dennishatton/TI-99-4a_SD_Disk_Project/TI99_DSR_patches/27c128 jumper.jpg

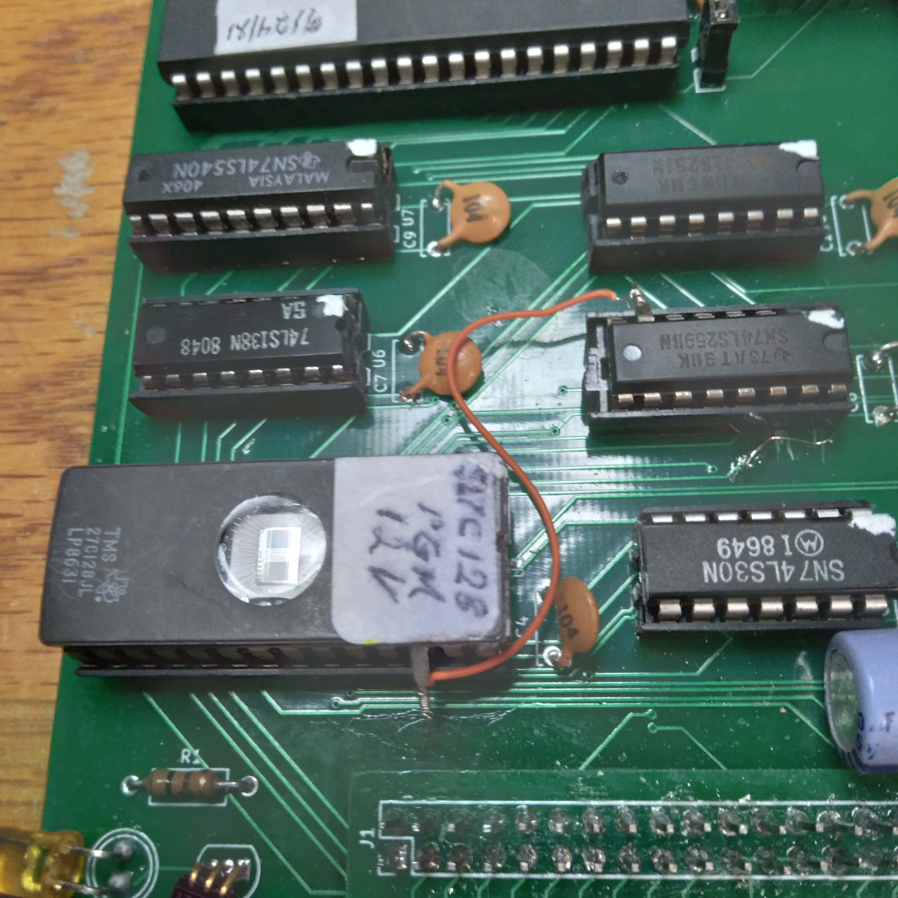
TI99_DSR_patches/27c128 jumper.jpg
