dennishatton/TI-99-4a_SD_Disk_Project/README.md

# TI-99/4a SD Disk Project
Allows TI to use floppy images on SD card

Note:<br />

	7/11/22
	Added DSK.volume#.filename to allow access to all volumes without being mounted.
	Added CALL CATALOG or CALL CAT due to conflict with RBX CALL CAT
	6/30/22
	16k patch.zip: Added CALL MAP To See which volumes are mounted to drives
	SD_Drive_540.zip Updated for CALL MAP
	MAP.zip
	I orignally use a 74ls541 as buffer and have two boards one with 74ls540
	Thinking it would be faster, But makes no difference.
	If you would like a copy of SD_Drive_541.zip Email me.
	6/27/22
	VOLMGR.ZIP highlighted volume number and fixed minor bugs
	6/25/22
	VolMgr.zip Added disk rename and quick format.
	Changed SYSTEM volume to 90k, Allows faster transf
	6/20/22
	TI99_DSR_patches:
	16k Patch.zip Added CALL CAT
	System:
	CALL VOLMGR.zip	Fixed transfer complete message
	Added CALL CAT.zip
	Added README (Subprograms Usage)
	TIVOL255
	
	6/12/22
	Change to load VolMgr from Volume 255, to allow updates to VolMgr
	volmgr.zip: Added auto repeat on keys, Added FCTN-4 Cancel to transfer
	SD_Drive_540.zip: Fixed transfer to only send size of volume instead of always 360k, Added monitor DSR pin for user cancel of transfer, 	Included avrasm2
	SD_Drive.zip: Tied DSR_EN 74LS259 Pin 4 to Atmega PD2 pin 12 to monitor User cancel of transfer.	

	6/6/22 	SD_Drive PCB removed 5v from pin 26 of 27C128 and tied to pin 7 of 74LS259,
	To allow optional 16k rom with CALL VOLMGR in DSR.
	5/27/22 Added Volume Manager EA5 to load into memory

	I have also uploaded 32K board, RS232/PIO board and ESP-01 adaptor for Telnet transfers
	
	I'm not trying to re-invent TI-99/4a or turn it into a PC.
	My goal is to keep it compatible with an original TI system.
	If you have already order the old PCBs as I have.
	You will need the adaptor board. See the Adaptor ReadMe.pdf in KiCad folder.
	The pin header will also be used for the optional 32K daughter board.
	I recommend you use a long pin wire wrap edge card connector for side port, If you want to mount in a case.
		
	This should go without saying but the edge card connector goes on back of the board, Not front components side.
	Also If you can't figure out where the emitter, base & collector is on a transistor. This project is not for you.
	Must power up SD drive first then console.

I built this on a wire wrap board and tested.<br />
I have included the KICAD schematic and PCB.<br />
You must format SD card to EXFAT allocation unit size 512k.<br />
The reason I use 512k clusters is make sure another file can't be save between volumes.<br />
You will need to find a TI DSR rom. I'm not including one.<br />
You can use TI DSR rom as is or apply patches for CALL MOUNT and 360k disk images<br />
I'm using an ATMEGA162 to interface with the TI. Source included for MPLABX<br />
The volumes are V9T9 sector images of TI disk.<br />
You can use Disk Manager 2 on TI or on PC use TI99DIR.<br />
I'm also including some PC utilties.<br />
To use the PC utilities, You will need Visual C++ Redistributable for Visual Studio 2019.<br />
Go here to download for your computer.<br />
https://support.microsoft.com/help/2977003/the-latest-supported-visual-c-downloads<br />
There is a cartridge VolumeMgr.bin to list volumes on the TI.<br />
The cartridge is optional, You will need FLASHROM99 to run it.<br />
<br />
If someone does build this, Please let me know.<br />
I have mine working for a couple years.<br />
<br />
You must use a 16MHz Atmega162<br />
Low High Extend<br />
with fuses FF D9 FF<br />
<br />
Can use ESP-01 adaptor to Telnet send/receive volumes from PC to SD Drive.<br />
Also allowed the TI to access the ATmega usart<br />
by writing to the FDC Command register and reading or writing data registers.<br />
0x83 read usart status, 0x84 read usart data, 0x85 write usart data.<br />
There is a 128 byte buffer storing status & char received. (64 chars)<br />
The baud is 115.2k 8N1.<br />
<br />
volmgr
Volume Manger.



DiskTest
Disk test with TI Disk Manager.

RS232Front
RS232Back
RS232Test
RS232 test with my EPROM programmer.

32KFront
32KBack
32KTest
32K Memory test.

flat
Upright
Attached with Velcro.
Remove the sliding door on the speech synthesizer helps it seat better.

TI_Telnet
TI Sending Volume to PC via Telnet Xmodem

PC_Telnet
PC Receiving Volume from TI via Telnet Xmodem 1.8 KB/Sec
