dennishatton/TI-99-4a_SD_Disk_Project/System/README.txt

Subprograms Usage: 

	CALL MOUNT(drive,volume)
	Mounts drive 1-3, volume 000-255

	CALL CATALOG or CALL CAT
	CALL CAT(drive) or CALL CAT(volume)
	Cataloges a drive 1-3 or volume 000-255

	CALL VOLMGR
	Volume Manager for SD Drive
	
	CALL MAP
	Displays which volumes are mounted to drives 1-3

	    (000-255)
	DSK.VOLUME#.filename
	Allows access to all volumes without being mounted
