dennishatton/TI-99-4a_SD_Disk_Project/KiCad_6/Adaptor Read Me.pdf

You only need the adaptor board if you using the old PCB.

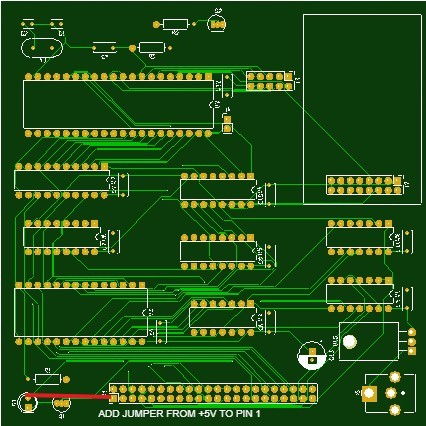
[picture p2: figure]

You need to add 5v jumper on the SD Drive board

Then

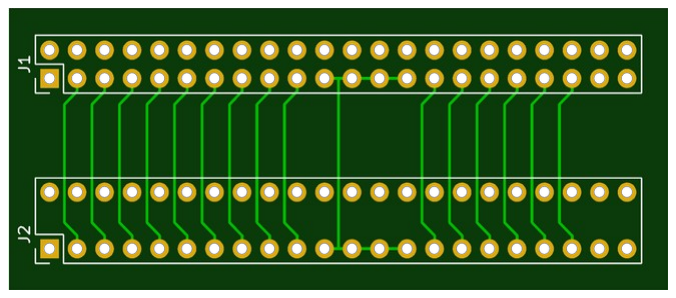
[picture p3: figure]

Solder pin header in at top of adaptor board and remove plastic base from header pins.

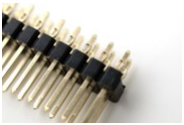
[picture p4: figure]

Insert the pins through the holes in the SD Drive board then solder to SD Drive board.

Install side port edge card connector at bottom of adaptor.
