dennishatton/TI-99-4a_SD_Disk_Project/(list of files, cad)

Other CAD files:
TI99_DSR_patches/Call_Mount.obj
TI_SD_Disk_Atmega162/MPLAB X v5/TI_SD_Disk_Atmega162.X/dist/default/production/TI_SD_Disk_Atmega162.X.production.obj
TISDMGR/TISDMGRC.obj
TI99_DSR_patches/360k_DSR_mod.obj
MPLABX/TI_SD_Disk_Atmega162.X/dist/default/production/TI_SD_Disk_Atmega162.X.production.obj
