dennishatton/TI-99-4a_SD_Disk_Project/KiCad/TI-994A SD_Drive/TI-994A SD_Drive.kicad_pcb

## KiCad design esp8266_relay_control_unit.sch


Parts:
C1, C2, C3: 1uF
C4: 0.1uF
D1: PWR_DIODE
J1: Conn_01x02
J2: Conn_02x04_Counter_Clockwise
K1: DIPxx-1Cxx-51x; Relay_StandexMeder_DIP_LowProfile
PS1: HLK-PM01; Converter_ACDC_HiLink_HLK-PMxx
R1, R2, R3: 10k
R4: 1k
SW1: SW_DIP_x01
U1: ESP-12E
U2: MIC5353-3.3YMT; MLF-6-1EP_1.6x1.6mm_P0.5mm_EP0.5x1.26mm
U3: DHT11; Aosong_DHT11_5.5x12.0_P2.54mm

Connections:
3V3: C2.1, C3.1, J2.4, R2.2, R3.2, R4.2, U2.4 (VOUT), U3.1 (VCC)
CH_PD: J2.2, R3.1
GND: C1.2, C2.2, C3.2, J1.1, J2.8, U2.2 (GND), U2.7 (GND), U3.4 (GND)
GPIO0: J2.6
GPIO2: J2.7, U3.2 (IO)
unnamed: C4.2, D1.2 (A), SW1.1
unnamed: D1.1 (K), R4.1
unnamed: K1.7, K1.8
unnamed: R1.1, U2.1 (EN)
RST: C4.1, J2.3, R2.1, SW1.2
RXD: J2.5
TXD: J2.1
VCC: C1.1, J1.2, R1.2, U2.3 (VIN)

Notes on the sheet:
Input voltage (3.7V ... 12V)
Temperature sensor shield https://bogza.ro/index.php/ESP8266_temperature_sensor
