dennishatton/TI-99-4a_SD_Disk_Project/(commit log)

2021-03-27 Add files via upload
    Added program header to schematic
2021-07-06 Add files via upload
    New Atmega 162 files.
    Removed the need to enter data into SD card sector 1 on setup.
    [360k_DSR_mod.obj, Call_Mount.obj, TI-994A SD_Drive.kicad_pcb, TI-994A SD_Drive.sch, TISDMGRC.obj, TI_SD_Disk_Atmega162.X.production.obj]
2021-07-07 Add files via upload
    Added work around for larger SD cards
    [TI_SD_Disk_Atmega162.X.production.obj]
2021-09-11 Add files via upload
    I have found a part error in schematic U7 is listed as a 74LS541 (non inverting buffer)
    It should be a 74LS7540 (inverting buffer)
    Sorry for the mistake.
    [TI-994A SD_Drive.kicad_pcb, TI-994A SD_Drive.sch]
2021-09-23 Add files via upload
    Renamed TIDMGR VolumeMgr.
    Added remote volume upload/download to PC by Telnet.
    Can catalog any volume without mounting it.
2022-04-18 Update README.md
    Warning about no 5v through speech synthesizer.
2022-04-24 Add files via upload
    Added PCB layout and Gerber files
2022-04-24 Update README.md
    Added PCB layout and Gerber files.
2022-04-26 Add files via upload
    No change in schematic.
    Updated some symbols
2022-04-29 Update README.md
    Uploaded new PCB with daughter board header.
2022-04-29 Add files via upload
    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
2022-05-08 Add files via upload
    Added both MPLABX and Microchip Studio 7
    [TI_SD_Disk_Atmega162.X.production.obj]
2022-05-12 Add files via upload
    Power was backwards on U3 74LS04
2022-05-17 Update README.md
    added images of pcb
2022-05-25 Add files via upload
    Added optional LED
2022-06-06 Add files via upload
    SD_Drive Removed 5v from pin 26 of 27C64 and tied to pin 7 of 74LS259,
    To allow optional 16k rom with CALL VOLMGR in DSR.
2022-06-06 Update README.md
    SD_Drive PCB removed 5v from pin 26 of 27C64 and tied to pin 7 of 74LS259,
    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
2022-06-12 Add files via upload
    Fixed transfer to only send size of volume instead of always 360k
    Added monitor DSR pin for user cancel of transfer
    Included avrasm2
2022-06-12 Add files via upload
    Tied DSR_EN 74LS259 Pin 4 to Atmega PD2 pin 12
    to monitor User cancel of transfer.
2022-07-12 Add files via upload
    Added CALL CATALOG or CALL CAT due to conflict with RBX CALL CAT
    Added DSK.VOLUME#.filename to allow access to all volumes without being mounted.
